cho45/QCdirect/circuit/circuit.pdf

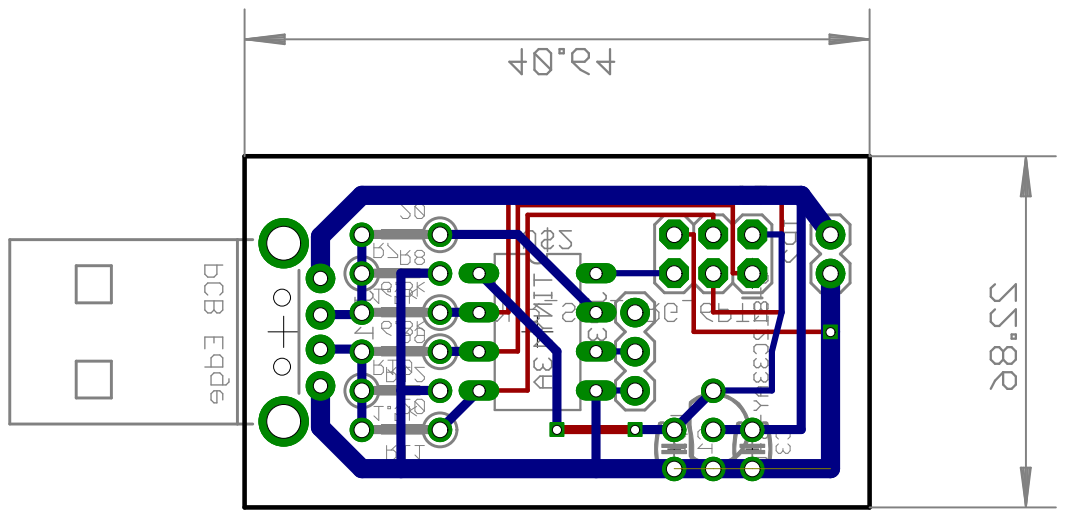
[picture p1: page 1]
