cho45/QCdirect/circuit/circuit.brd

## EAGLE design circuit/circuit.brd (2015-12-24)

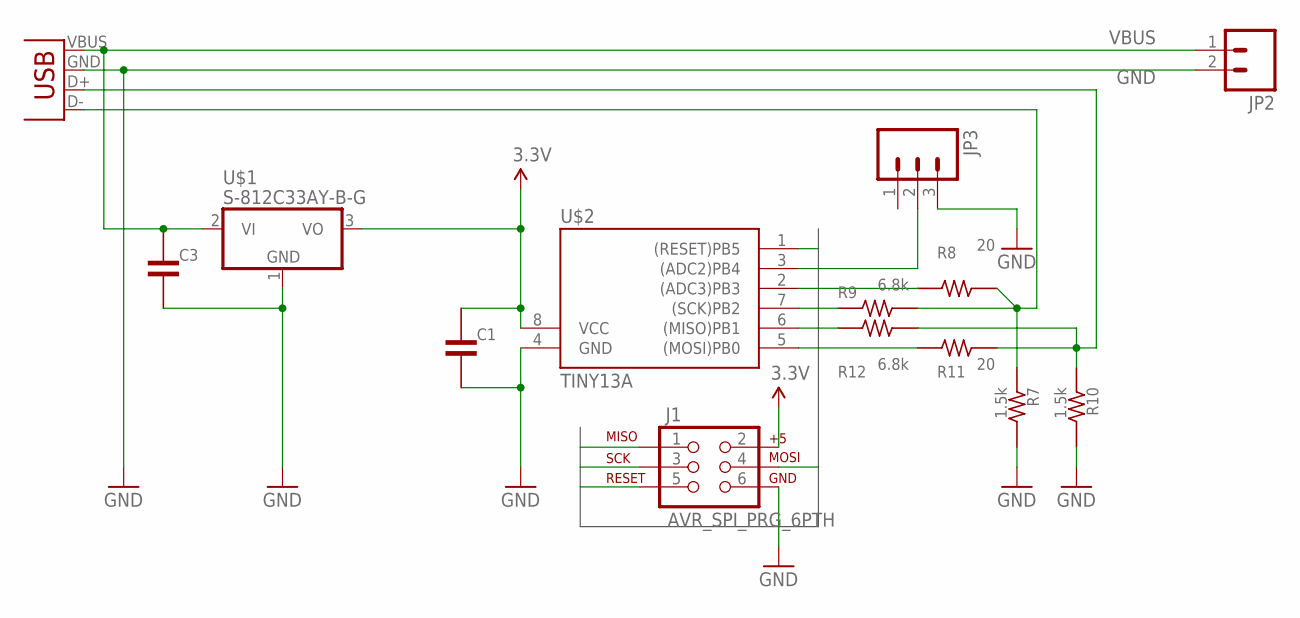
[picture p2: schematic circuit.sch]

Parts:
C1, C3: C-50V-0302-2.54; 50-0302-2.54
J1: AVR_SPI_PRG_6PTH; 2X3
JP1: USB-A-H
JP2: M02PTH; 1X02
JP3: M03PTH; 1X03
R7, R10: 1.5k; 1/4W-5.08V
R8, R11: 20; 1/4W-5.08V
R9, R12: 6.8k; 1/4W-5.08V
U$1: S-812C33AY-B-G; TO-92
U$2: TINY13A; DIL08

Connections:
0.6V2: JP1.D- (D+), R7.PAD1 (1), R8.PAD2 (2), R9.PAD2 (2)
0.6V3: JP1.D+ (D-), R10.PAD1 (1), R11.PAD2 (2), R12.PAD2 (2)
3.3V: C1.PAD1 (1), J1.2, U$1.3 (VO), U$2.8 (VCC)
GND: C1.PAD2 (2), C3.PAD2 (2), J1.6, JP1.GND (VBUS), JP2.2, JP3.3, R7.PAD2 (2), R10.PAD2 (2), U$1.1 (GND), U$2.4 (GND)
MISO: J1.1, R12.PAD1 (1), U$2.6 ((MISO)PB1)
MOSI: J1.4, R11.PAD1 (1), U$2.5 ((MOSI)PB0)
unnamed: R8.PAD1 (1), U$2.2 ((ADC3)PB3)
unnamed: JP3.2, U$2.3 ((ADC2)PB4)
RESET: J1.5, U$2.1 ((RESET)PB5)
SCK: J1.3, R9.PAD1 (1), U$2.7 ((SCK)PB2)
VBUS: C3.PAD1 (1), JP1.VBUS (GND), JP2.1, U$1.2 (VI)

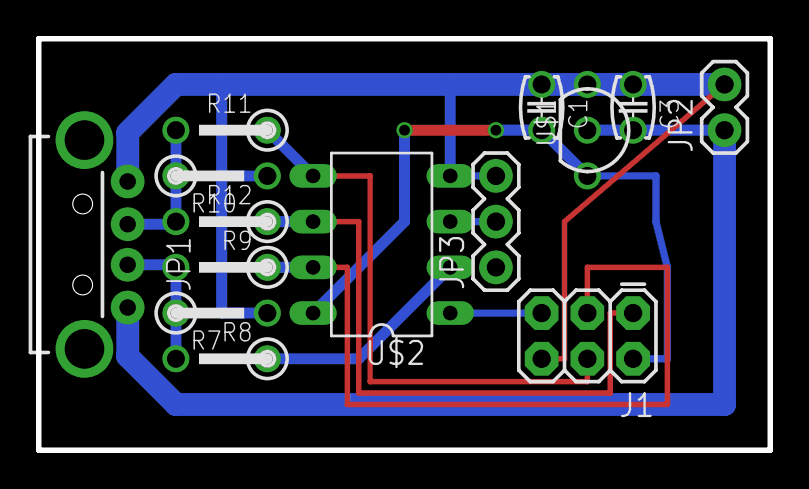
[picture p3: board circuit.brd from above]

Board: 2 copper layers, 40.6 x 22.9 mm, 14 parts (0 on the bottom side), 11 nets.
